P2fryang/animatronic-bobblehead/media/top_down_thumbnail.png

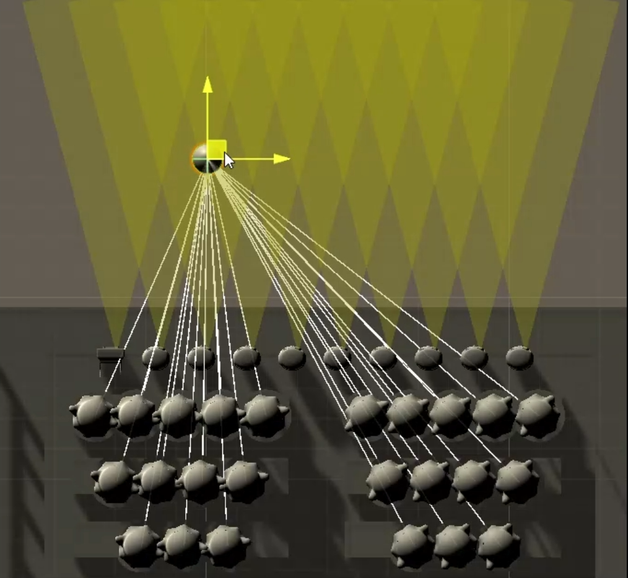
media/top_down_thumbnail.png
